EmperorFederico/EFClock/(list of files, drawings)

Other design files:
Devre/Devre.pdsprj
